VinhThoHo/ph_air_shower_hw/ph_air_shower_relay_hw/README.md

# ph_pcr_cabinet_relay_hw
This is relay hardware for project PCR Cabinets.

# Description

## Features:
    * Điện áp ngõ vào 12VDC.
    * Hỗ trợ 3 ngõ ra kích hoạt thông qua các relay.
    * Hỗ trợ 5 cổng output mở rộng kết nối với các thiết bị ngoại vi.
# Hardware
## Schematics

[Download](./ph_pcr_cabinet_relay_hw.pdf)

## PCB Layout

PCB-IMG

## 3D

TOP-3D-IMG

BOT-3D-IMG

## Pinout

# Gerber

[Download](./gerber/gerber_ph_pcr_cabinet_relay_hw.zip)

# BOMLIST

[Download](./assets/ph_pcr_cabinet_relay_hw.csv)

# FRAME PCB

[Download](./assets/ph_pcr_cabinet_frame_relay.dxf)

# License

PHUONGHAI
