VinhThoHo/ph_air_shower_hw/ph_air_shower_relay_hw/assets/ph_air_shower_relay_3d_bot_hw.png

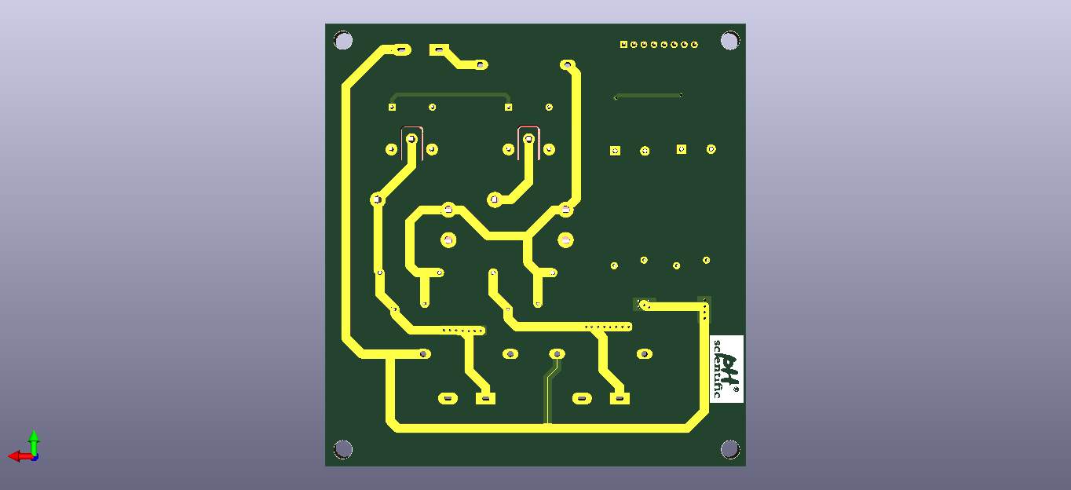
ph_air_shower_relay_hw/assets/ph_air_shower_relay_3d_bot_hw.png
