VinhThoHo/ph_air_shower_hw/ph_air_shower_relay_hw/assets/ph_frame_air_shower_relay_hw.dxf

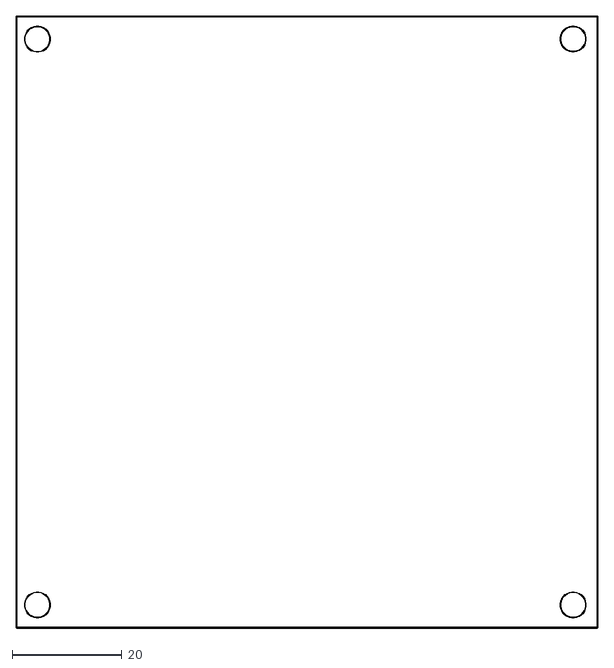
[picture p5: CAD file, 2020-05-18]
ph_air_shower_relay_hw/assets/ph_frame_air_shower_relay_hw.dxf
105.8 x 111.4
