VinhThoHo/ph_air_shower_hw/Documents/Diagram_Block_Air_Shower.pdf

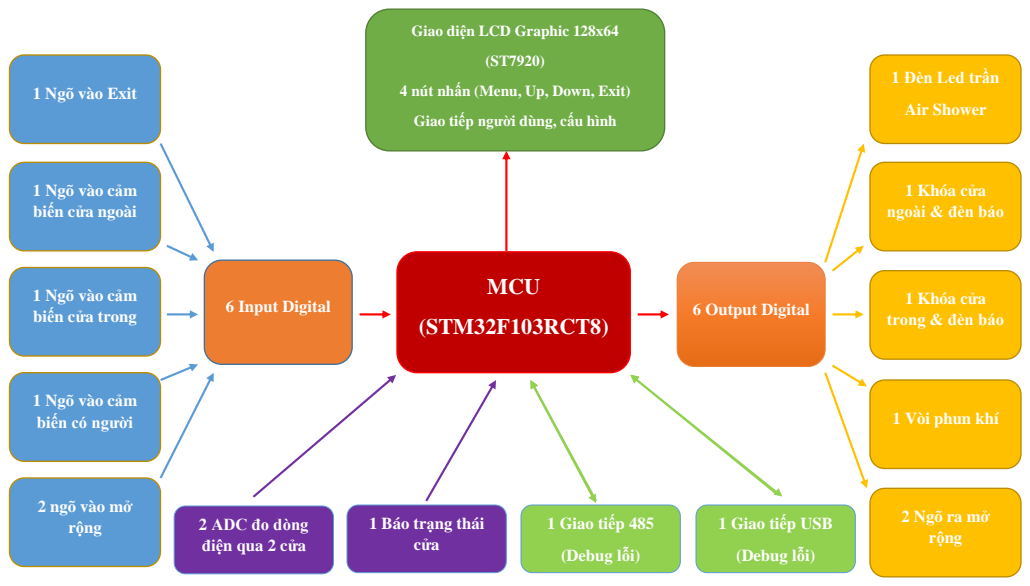
[picture p6: page 1]
MCU; (STM32F103RCT8); 6 Input Digital; 1 Giao tiếp 485; (Debug lỗi); 6 Output Digital; Air Shower; cửa

Giao diện LCD Graphic 128x64

1 Đèn Led trần

4 nút nhấn (Menu, Up, Down, Exit)

1 Ngõ vào Exit

Giao tiếp người dùng, cấu hình

1 Ngõ vào cảm
biến cửa ngoài

1 Khóa cửa
ngoài & đèn báo

biến cửa trong

trong & đèn báo

biến có người

1 Vòi phun khí

2 ngõ vào mở
rộng

1 Giao tiếp USB

2 Ngõ ra mở

2 ADC đo dòng
điện qua 2 cửa

1 Báo trạng thái
