VinhThoHo/ph_air_shower_hw/Documents/diagram_system_connect_ph_air_shower_hw.pdf

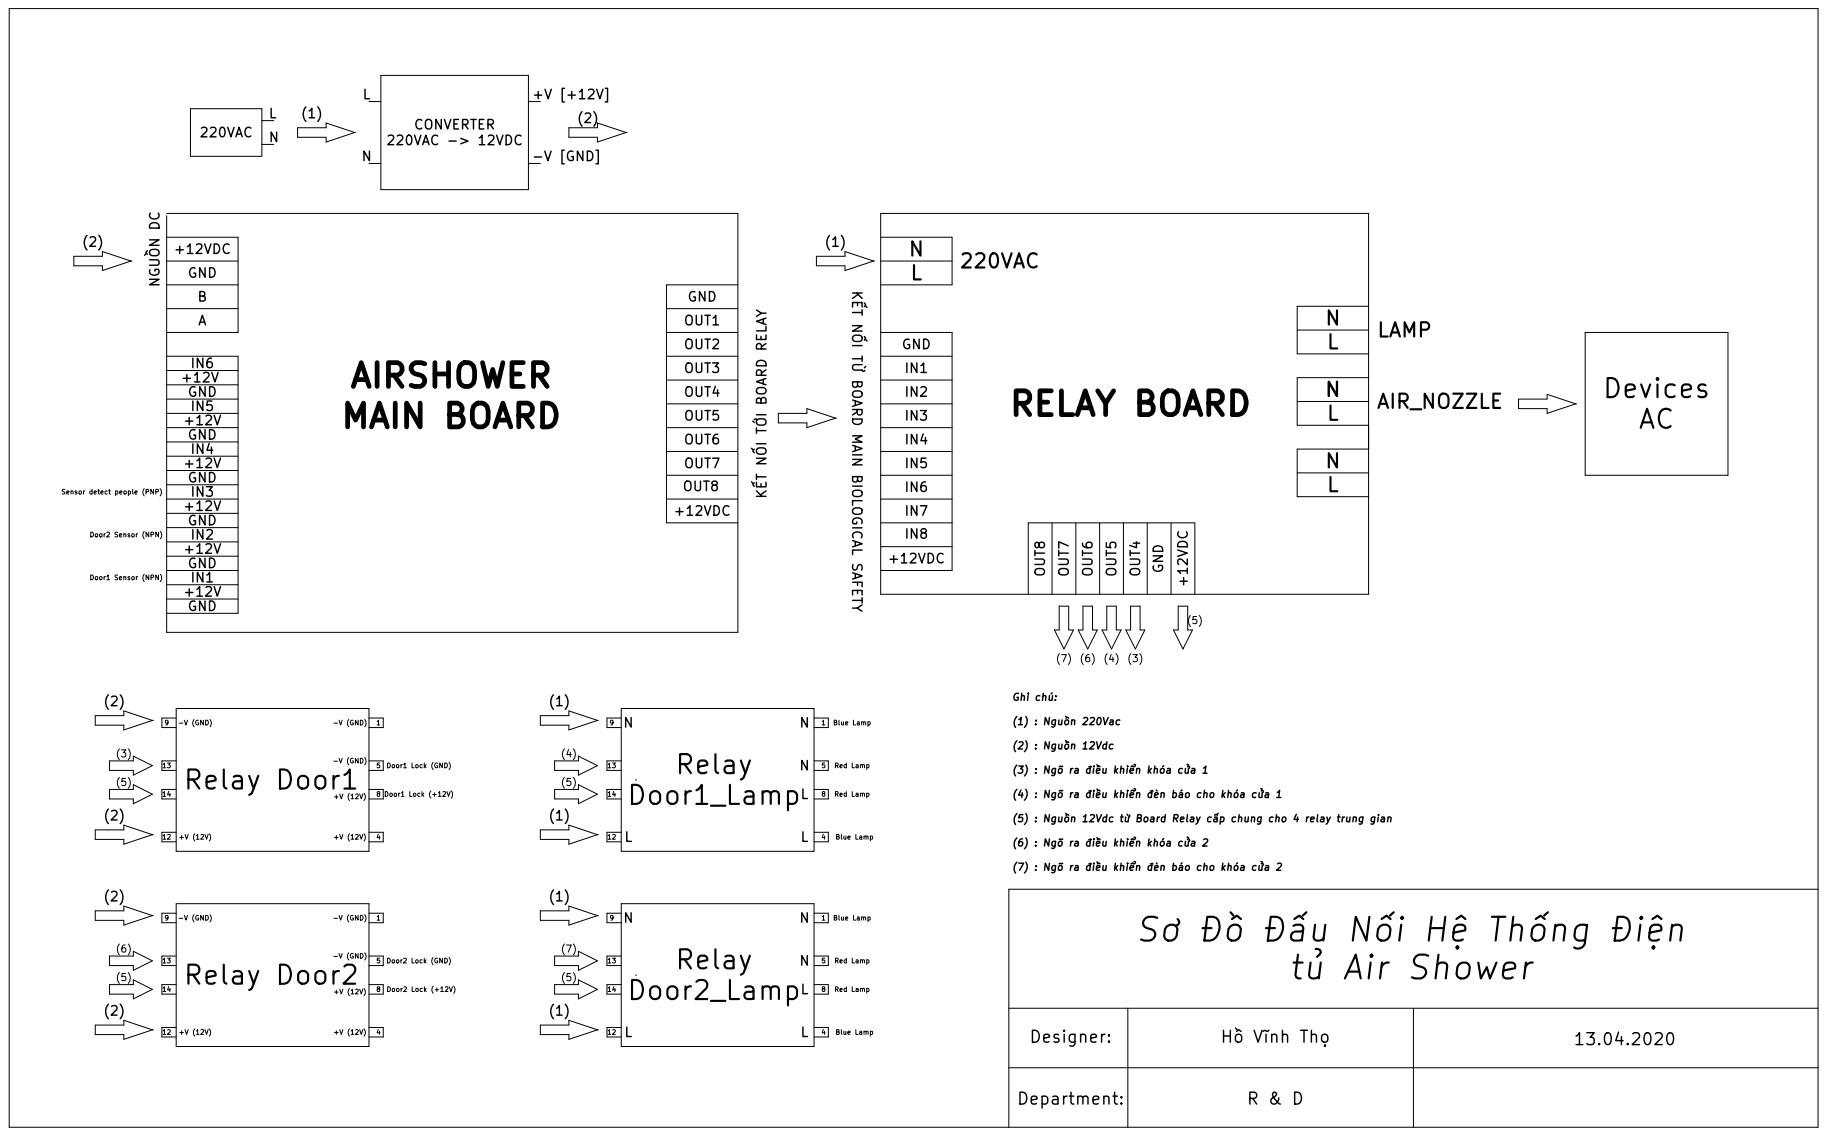
[picture p7: page 1]

IN5
+12V
IN4
IN3
IN2
IN1

Red Lamp

(3) : Ngõ ra iu khin khóa ca 1

(4) : Ngõ ra iu khin èn báo cho khóa ca 1

(5) : Ngun 12Vdc t Board Relay cp chung cho 4 relay trung gian

(6) : Ngõ ra iu khin khóa ca 2

(7) : Ngõ ra iu khin èn báo cho khóa ca 2

Designer: | | 13.04.2020

Department: | R & D
