VinhThoHo/ph_air_shower_hw/ph_air_shower_controller_hw/documents/diagram_system_connect_ph_air_shower_hw.pdf

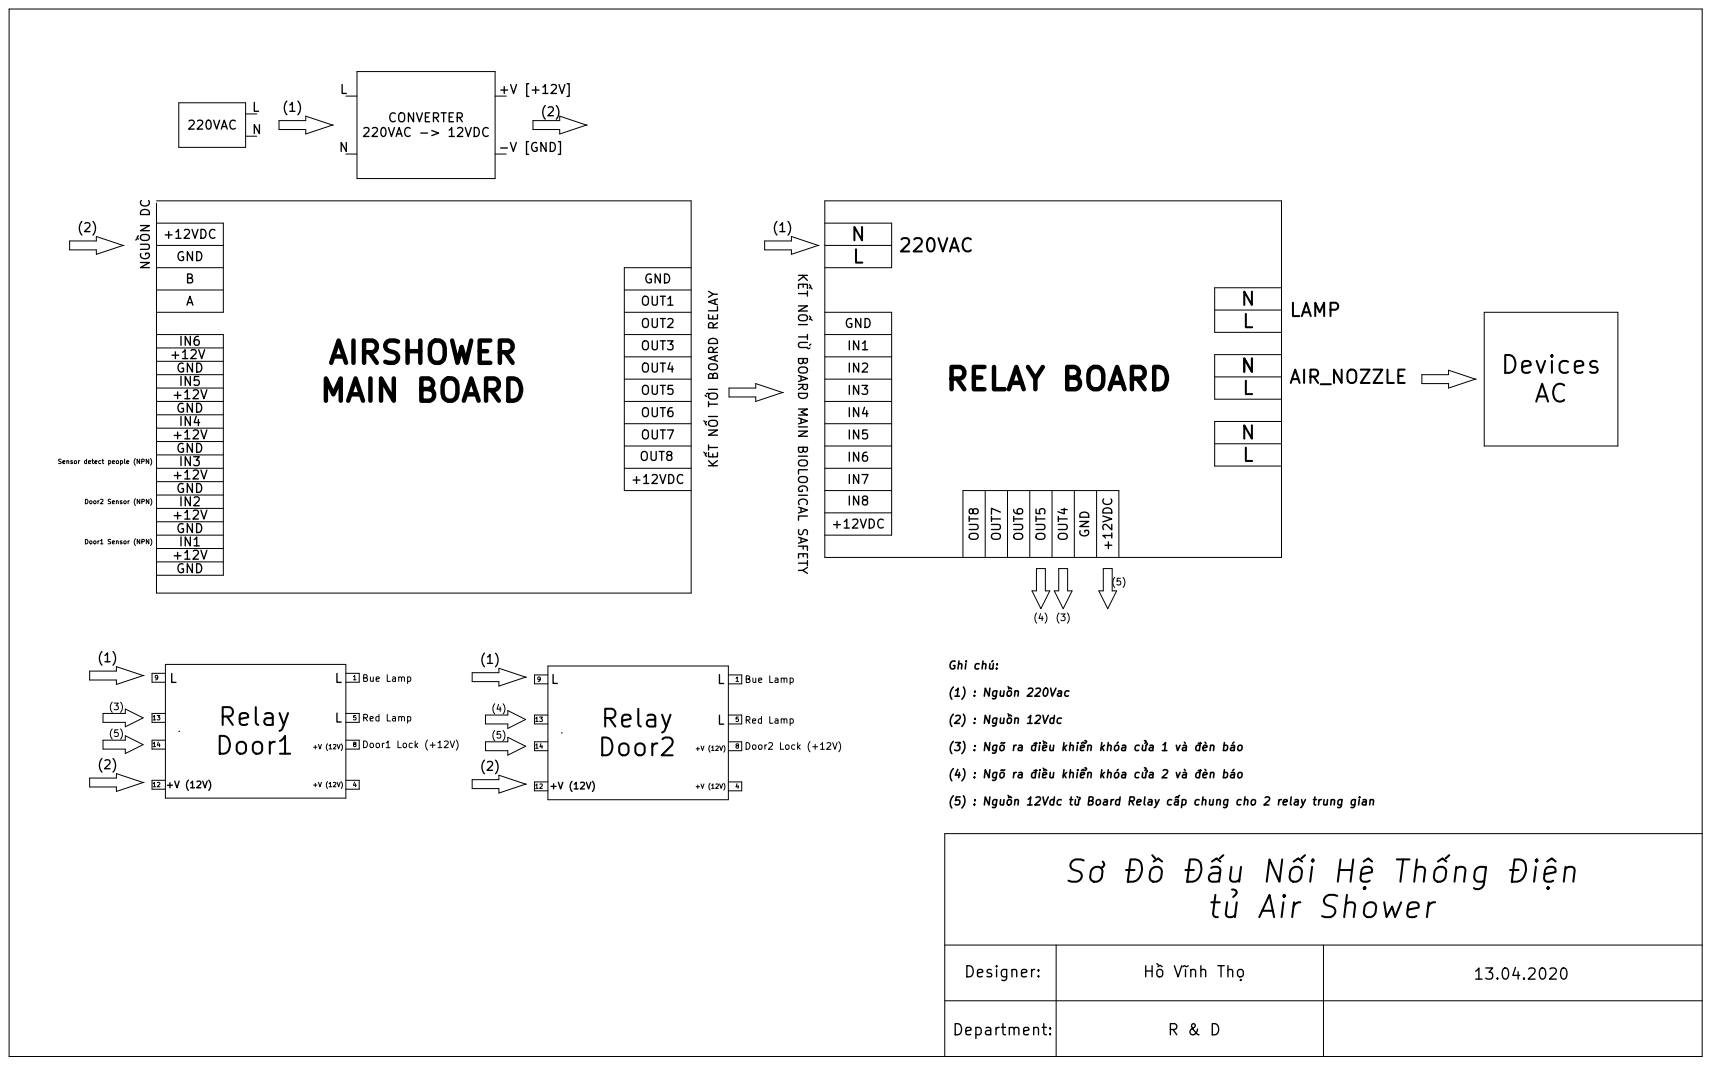
[picture p8: page 1]

IN5
+12V
IN4
IN3
IN2
IN1

(3) : Ngõ ra iu khin khóa ca 1 và èn báo

(4) : Ngõ ra iu khin khóa ca 2 và èn báo

(5) : Ngun 12Vdc t Board Relay cp chung cho 2 relay trung gian

Designer: | | 13.04.2020

Department: | R & D
