VinhThoHo/ph_air_shower_hw/ph_air_shower_relay_hw/ph_air_shower_relay(2C)_hw.pdf

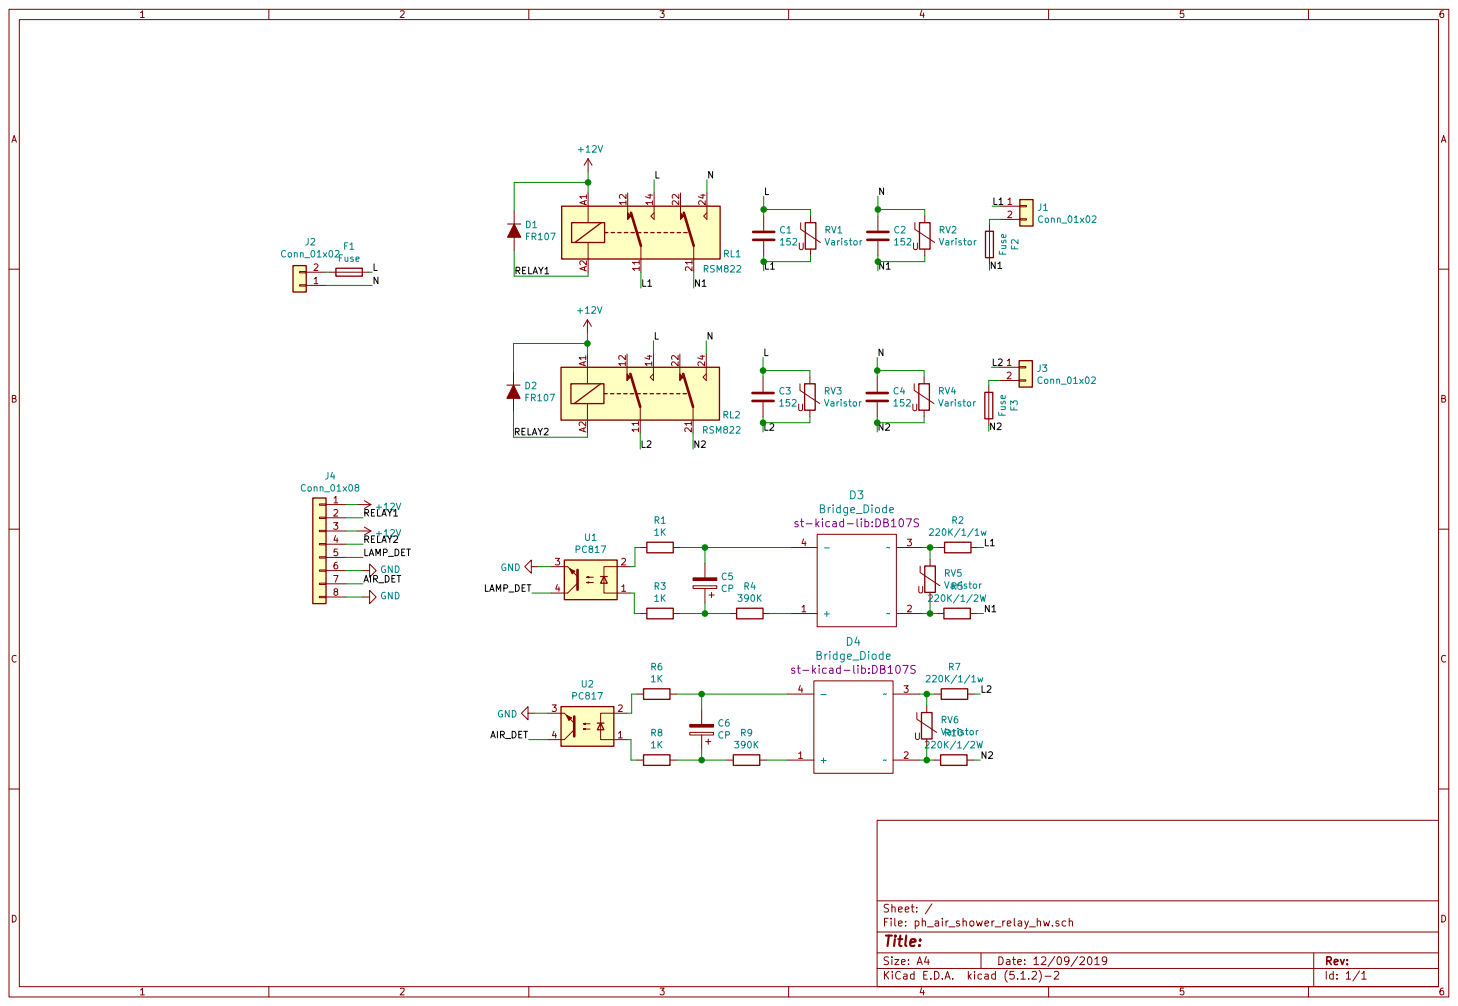
[picture p9: page 1]
