VinhThoHo/ph_air_shower_hw/ph_air_shower_controller_hw/documents/ph_air_shower_controller_hw.pdf

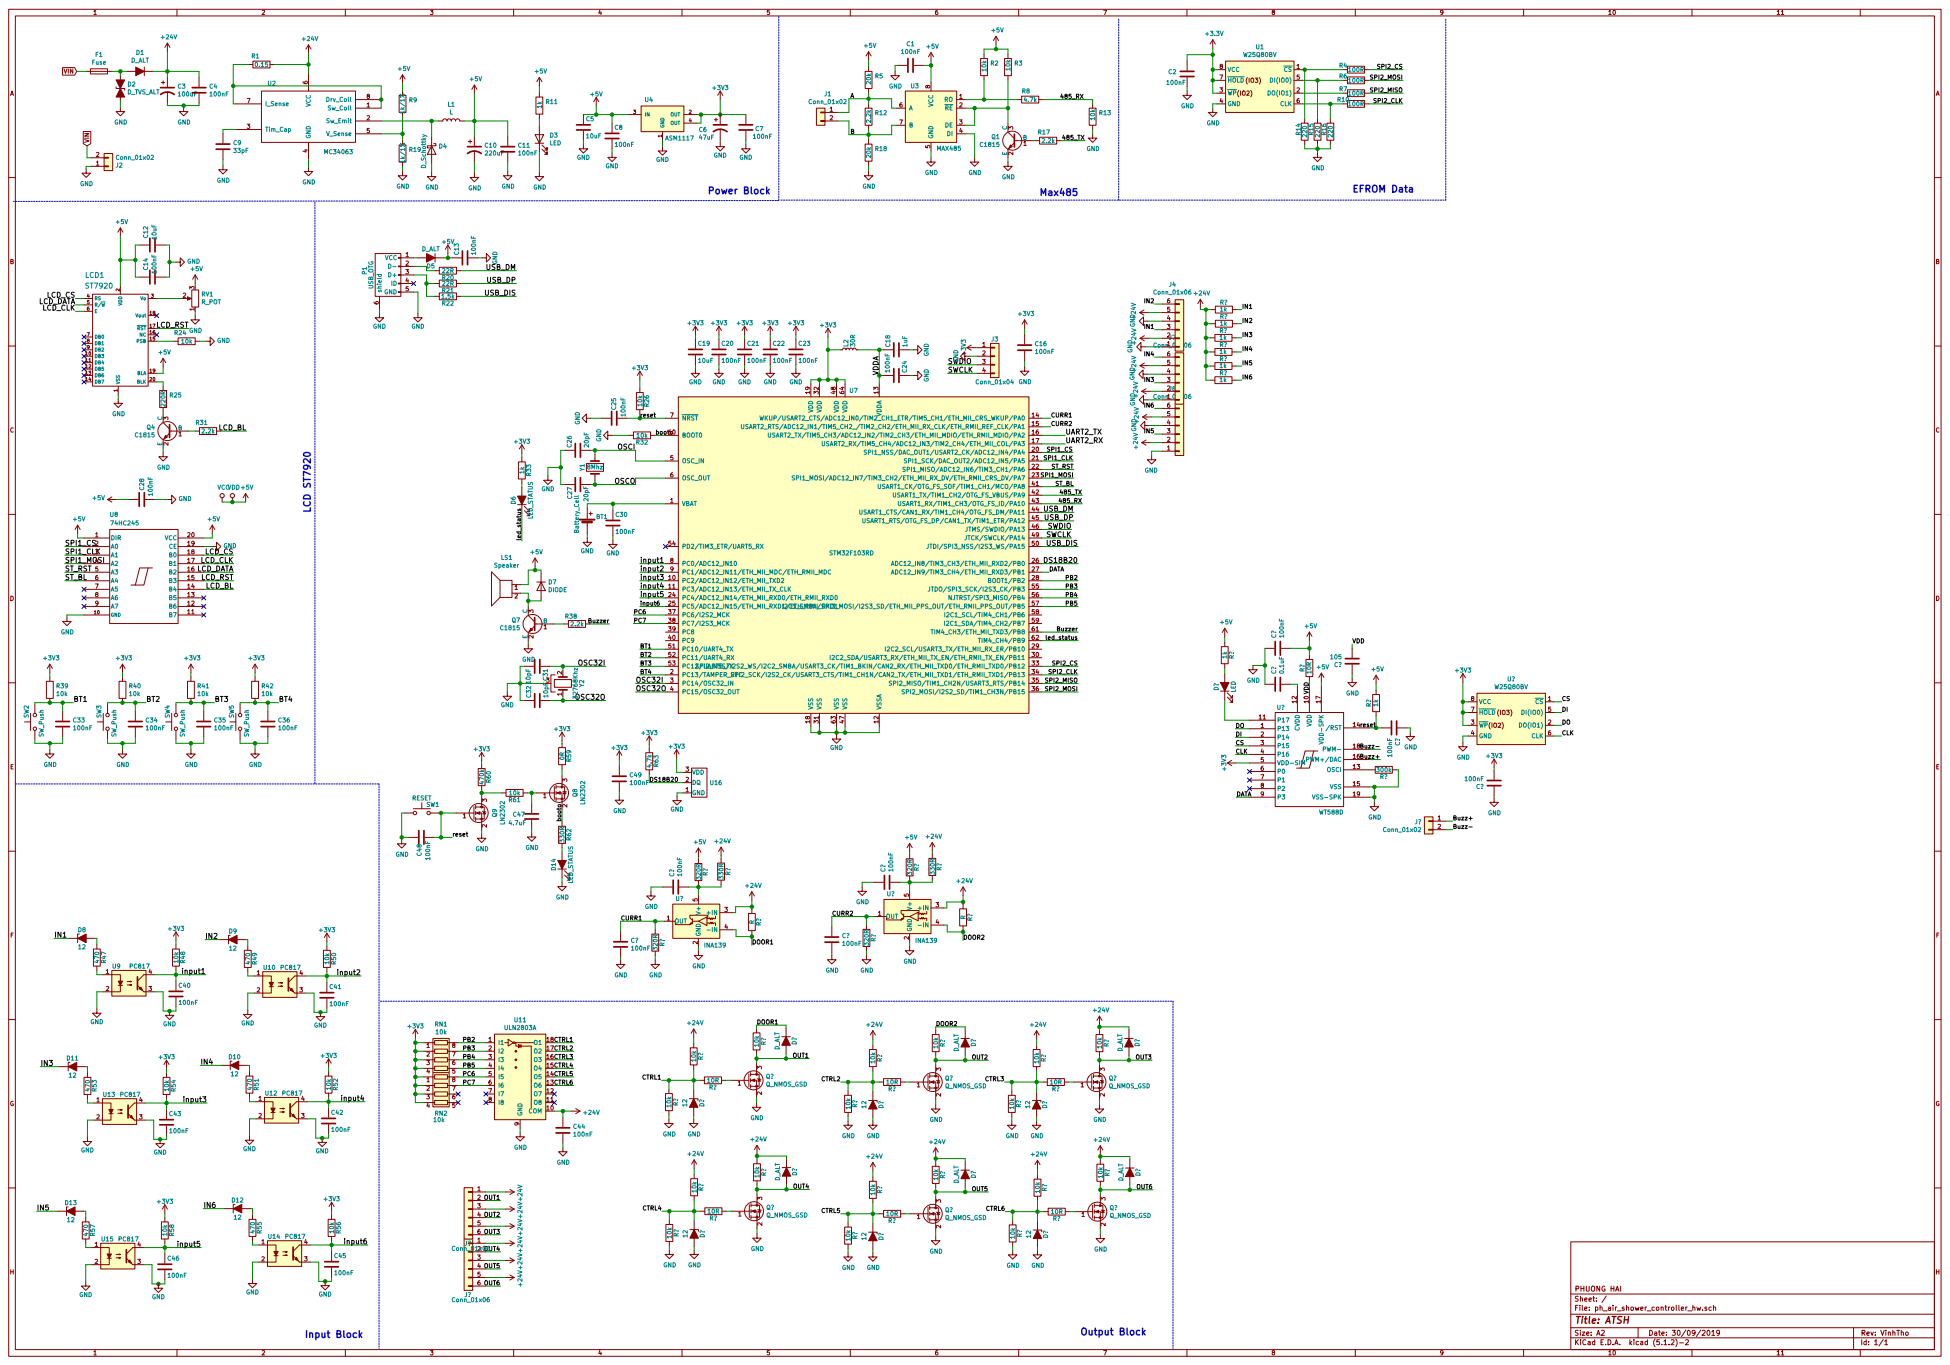
[picture p10: page 1]

1 DB3 10 DB4 11 DB5 12 DB6 13 DB7 14 PSB 15 NC 16 RST 17 Vout 18 BLA 19 VDD

JTMS/SWDIO/PA13 46 VSS 47 VDD 48

LCD_CLK
LCD_DATA
LCD_RST

1 | 10k 1 | | I2 2
2 | | PB2 PB3 PB4 PB5 PC6 PC7 7 | I3 3

3 | | 6 | I4 4
4 | | 5 | I5 5
2 | 8 RN2 7 | I7 7

File: ph_air_shower_controller_hw.sch Sheet: / PHUONG HAI
