VinhThoHo/ph_air_shower_hw/ph_air_shower_controller_hw/ph_air_shower_controller_hw.kicad_pcb

## KiCad design ph_air_shower_controller_hw/ph_air_shower_controller_hw.kicad_pcb (2020-03-13)

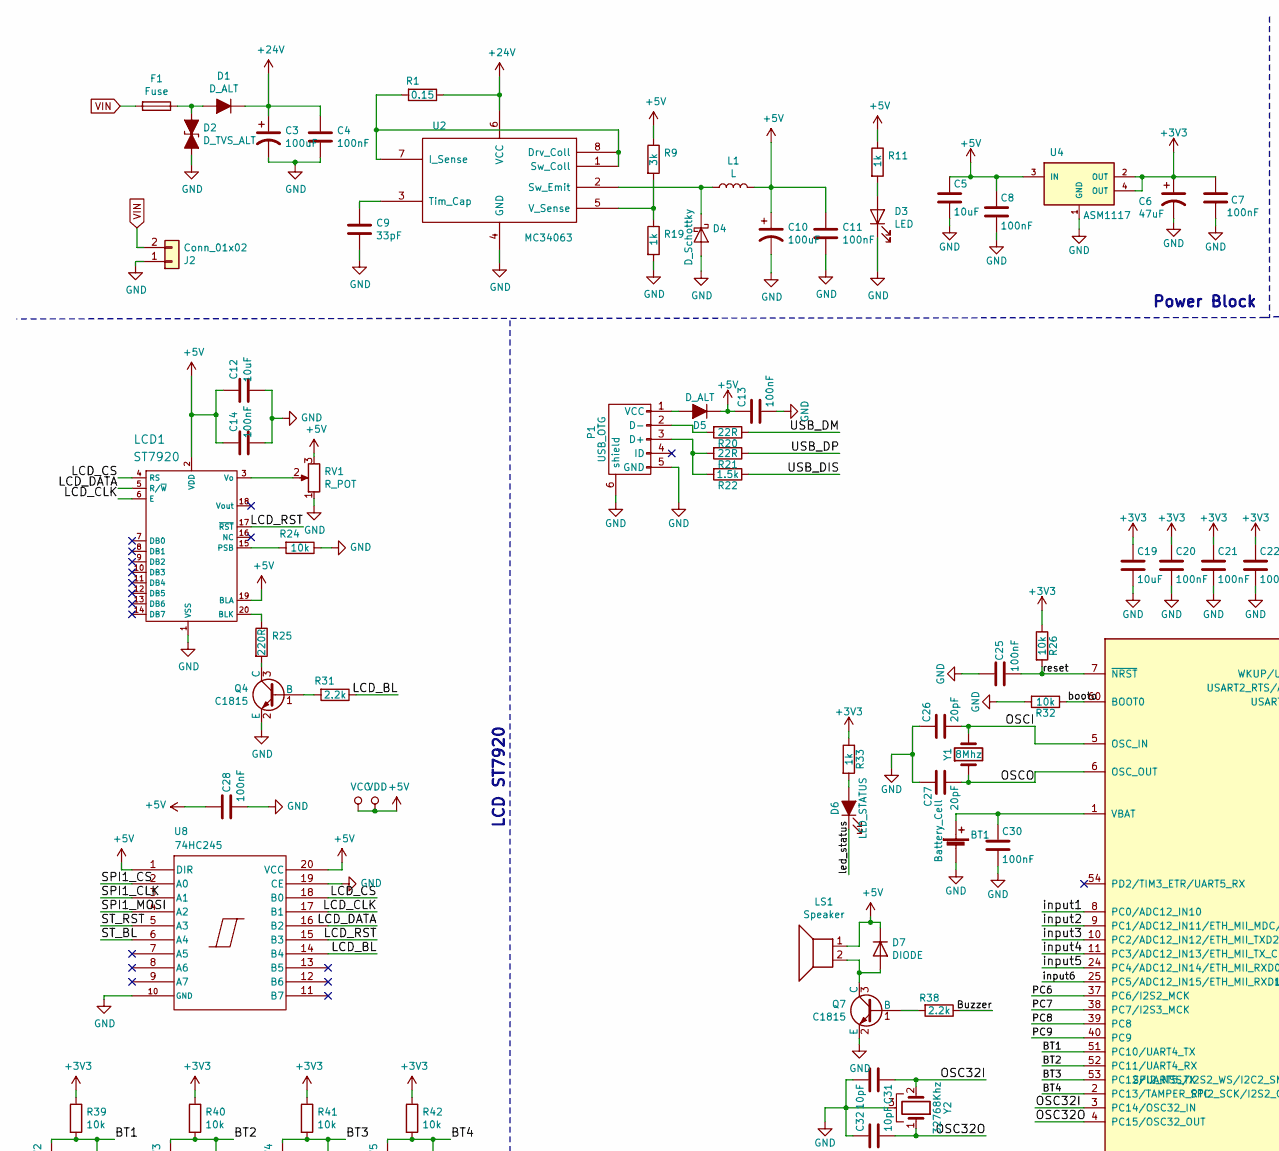
[picture p11: schematic ph_air_shower_controller_hw.sch, ATSH, part in row 1, column 1]

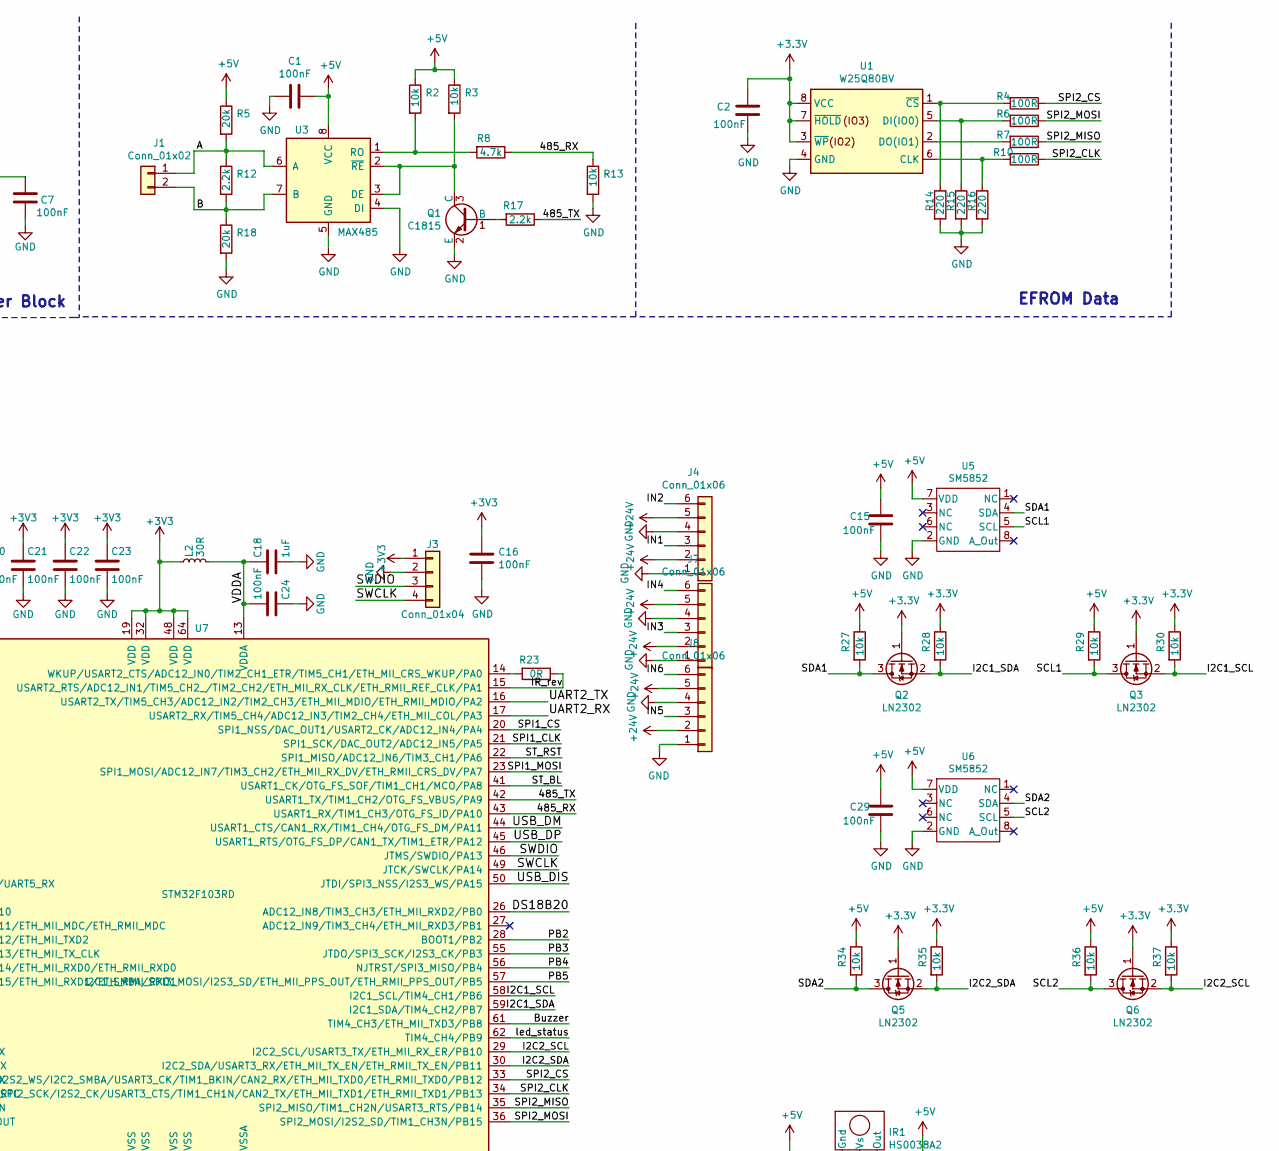
[picture p12: schematic ph_air_shower_controller_hw.sch, ATSH, part in row 1, column 2]

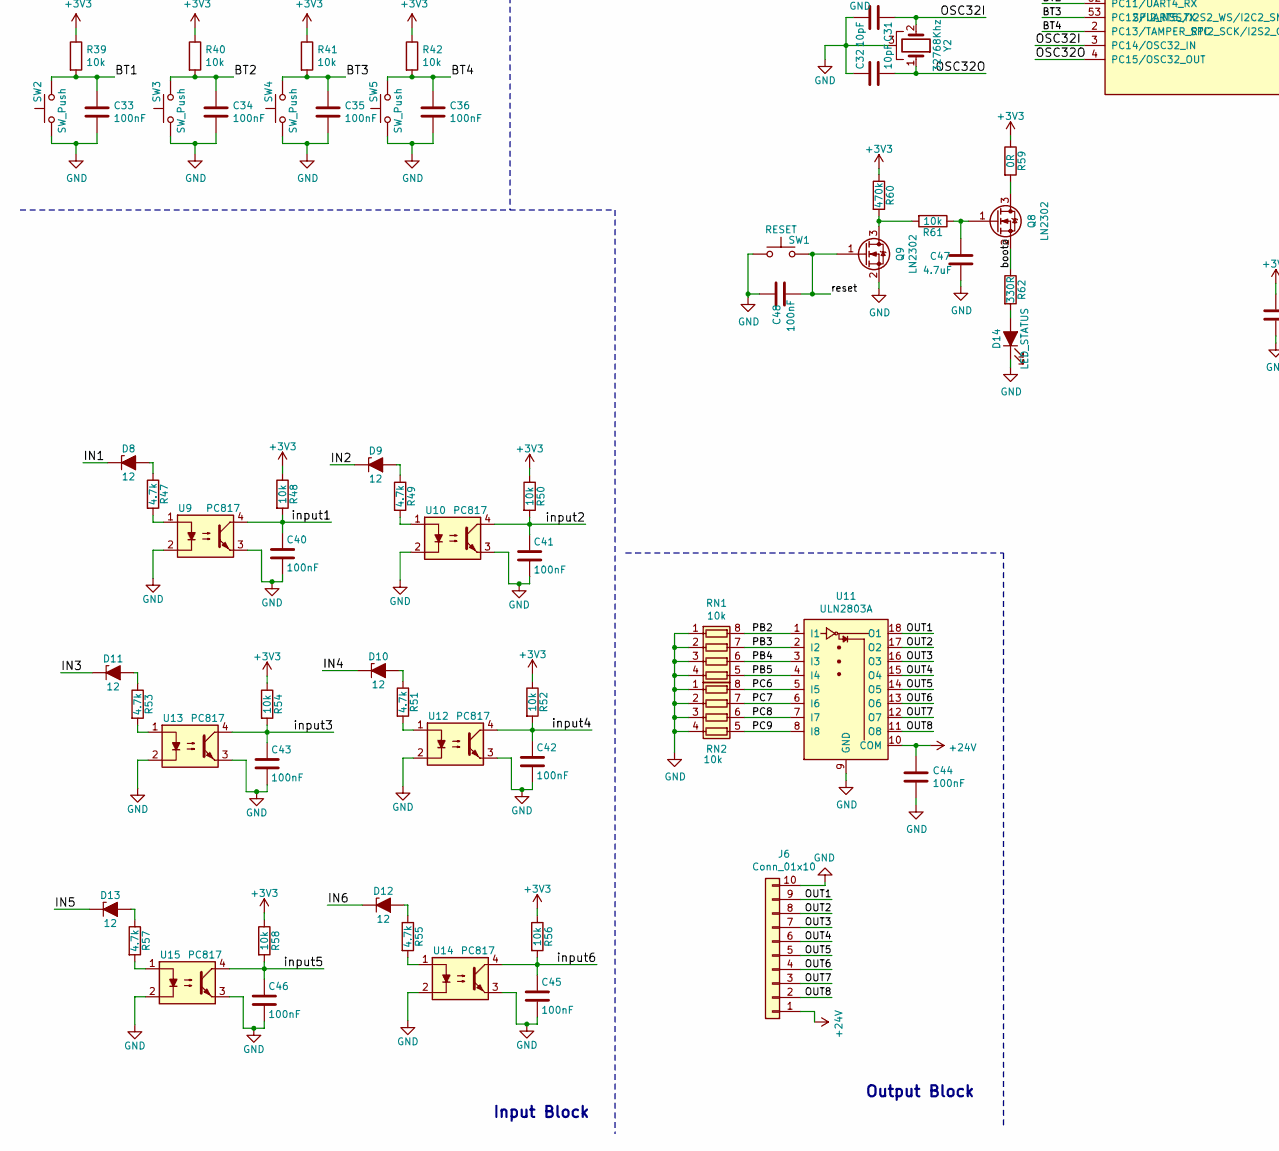
[picture p13: schematic ph_air_shower_controller_hw.sch, ATSH, part in row 2, column 1]

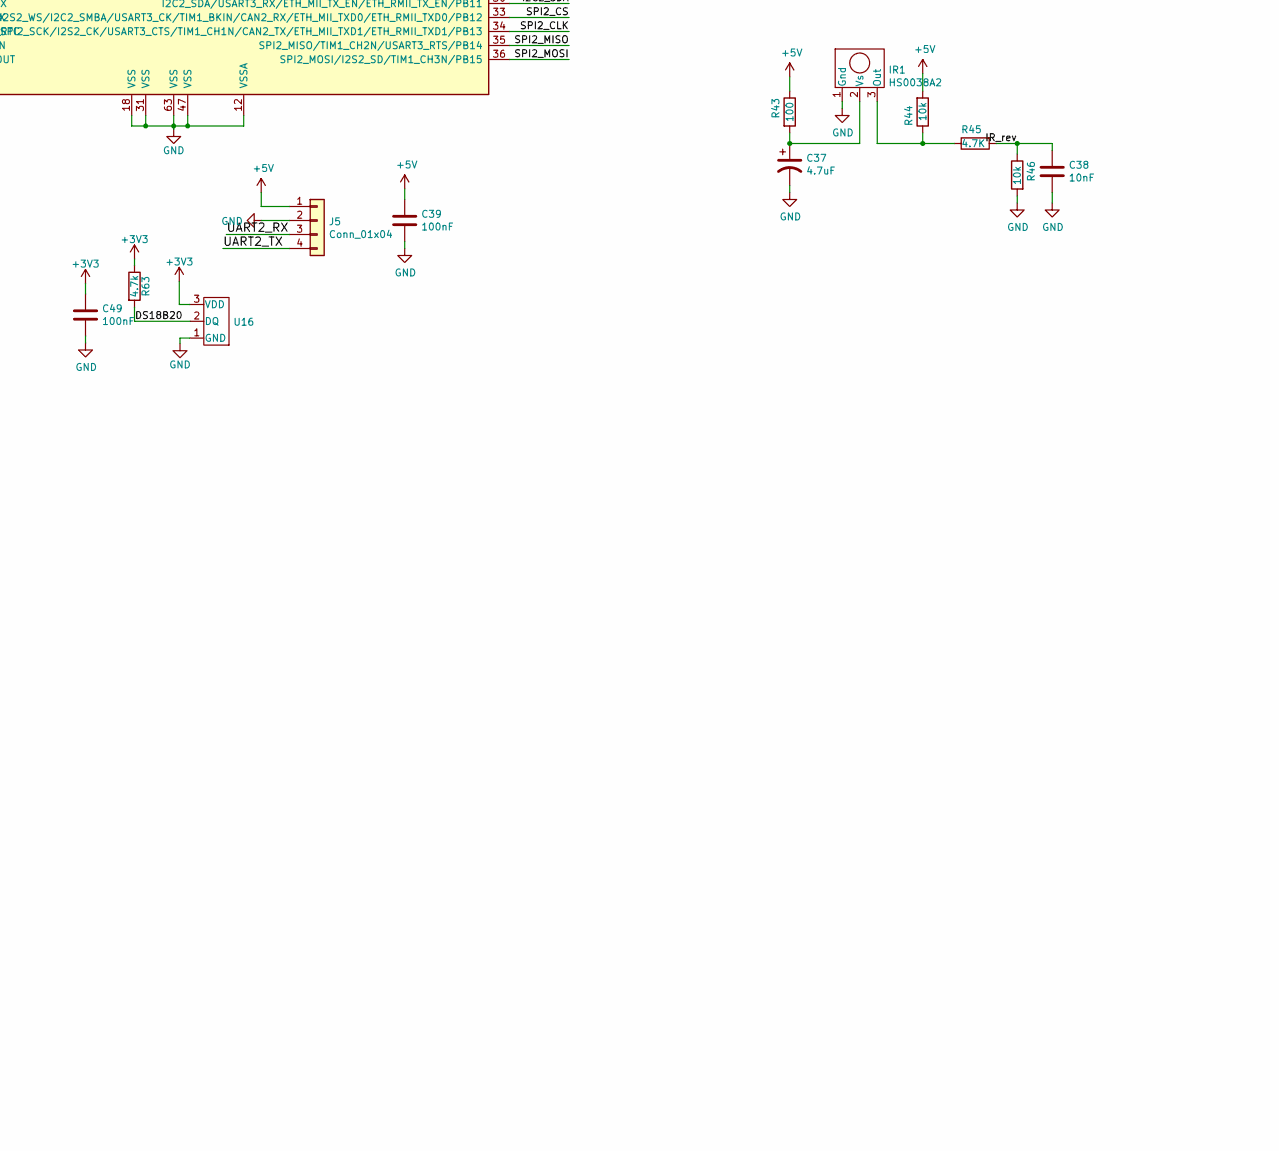
[picture p14: schematic ph_air_shower_controller_hw.sch, ATSH, part in row 2, column 2]

Parts:
BT1: Battery_Cell; BT3V3
C1, C2, C4, C7, C8, C11, C13, C14, C15, C16, C20, C21, C22, C23, C24, C25, C28, C29, C30, C33, C34, C35, C36, C39, C40, C41, C42, C43, C44, C45, C46, C48, C49: 100nF; C_0805_2012Metric_Pad1.15x1.40mm_HandSolder
C3, C10: 100uF; CP_Elec_8x10.5
C5, C12, C19: 10uF; C_1206_3216Metric_Pad1.42x1.75mm_HandSolder
C6: 47uF; CP_Elec_5x5.4
C9: 33pF; C_0805_2012Metric_Pad1.15x1.40mm_HandSolder
C18: 1uF; C_0805_2012Metric_Pad1.15x1.40mm_HandSolder
C26, C27: 20pF; C_0805_2012Metric_Pad1.15x1.40mm_HandSolder
C31, C32: 10pF; C_0805_2012Metric_Pad1.15x1.40mm_HandSolder
C37: 4.7uF; CP_EIA-3216-18_Kemet-A_Pad1.58x1.35mm_HandSolder
C38: 10nF; C_0805_2012Metric_Pad1.15x1.40mm_HandSolder
C47: 4.7uF; C_1206_3216Metric_Pad1.42x1.75mm_HandSolder
D1: D_ALT; D_SMB_Handsoldering
D2: D_TVS_ALT; D_SMA_Standard
D3: LED; LED_0805_2012Metric_Pad1.15x1.40mm_HandSolder
D4: D_Schottky; D_SMA_Handsoldering
D5: D_ALT; D_SOD-123
D6, D14: LED_STATUS; LED_0805_2012Metric_Pad1.15x1.40mm_HandSolder
D7: DIODE; D_SOD-123
D8, D9, D10, D11, D12, D13: 12; SOD-80
F1: Fuse; Fuse_SMD1812
IR1: HS0038A2
J1, J2: Conn_01x02; TerminalBlock_WAGO-236_2Stift_R5mm_2pol
J3, J5: Conn_01x04; Pin_Header_Straight_1x04_Pitch2.54mm
J4, J7, J8: Conn_01x06; TerminalBlock_WAGO_2.54mm_6P
J6: Conn_01x10; PinSocket_1x10_P2.54mm_Vertical
L1: L; Inductor_5.2x5.8x4.5
L2: 30R; L_0805_2012Metric_Pad1.15x1.40mm_HandSolder
LCD1: ST7920
LS1: Speaker; Buzzer_15x7.5RM7.6
P1: USB_OTG; USB_Micro-B
Q1, Q4, Q7: C1815; SOT-23
Q2, Q3, Q5, Q6, Q8, Q9: LN2302; SOT-23
R1: 0.15; R_1206_3216Metric_Pad1.42x1.75mm_HandSolder
R2, R3, R13, R24, R26, R27, R28, R29, R30, R32, R34, R35, R36, R37, R39, R40, R41, R42, R44, R46, R48, R50, R52, R54, R56, R58, R61: 10k; R_0805_2012Metric_Pad1.15x1.40mm_HandSolder
R4, R6, R7, R10: 100R; R_0805_2012Metric_Pad1.15x1.40mm_HandSolder
R5, R18: 20k; R_0805_2012Metric_Pad1.15x1.40mm_HandSolder
R8, R47, R49, R51, R53, R55, R57, R63: 4.7k; R_0805_2012Metric_Pad1.15x1.40mm_HandSolder
R9: 3k; R_0805_2012Metric_Pad1.15x1.40mm_HandSolder
R11, R19, R33: 1k; R_0805_2012Metric_Pad1.15x1.40mm_HandSolder
R12, R17, R31, R38: 2.2k; R_0805_2012Metric_Pad1.15x1.40mm_HandSolder
R14, R15, R16: 220; R_0805_2012Metric_Pad1.15x1.40mm_HandSolder
R20, R21: 22R; R_0805_2012Metric_Pad1.15x1.40mm_HandSolder
R22: 1.5k; R_0805_2012Metric_Pad1.15x1.40mm_HandSolder
R23, R59: 0R; R_0805_2012Metric_Pad1.15x1.40mm_HandSolder
R25: 220R; R_0805_2012Metric_Pad1.15x1.40mm_HandSolder
R43: 100; R_0805_2012Metric_Pad1.15x1.40mm_HandSolder
R45: 4.7K; R_0805_2012Metric_Pad1.15x1.40mm_HandSolder
R60: 470k; R_0805_2012Metric_Pad1.15x1.40mm_HandSolder
R62: 330R; R_0805_2012Metric_Pad1.15x1.40mm_HandSolder
RN1, RN2: 10k; R_Array_Convex_4x0603
RV1: R_POT; VR1
SW1: RESET; Button_SW_2PIN
SW2, SW3, SW4, SW5: SW_Push; SW_PUSH-12mm
U1: W25Q80BV; SOIC-8_3.9x4.9mm_Pitch1.27mm
U2: MC34063; SOIC-8_3.9x4.9mm_Pitch1.27mm
U3: MAX485; SOIC-8_3.9x4.9mm_Pitch1.27mm
U4: ASM1117; SOT-223
U5, U6: SM5852
U7: STM32F103RD; LQFP-64_10x10mm_Pitch0.5mm
U8: 74HC245; TSSOP-20_4.4x6.5mm_Pitch0.65mm
U9, U10, U12, U13, U14, U15: PC817; Optocoupler_SMD
U11: ULN2803A; SOIC-18W_7.5x11.6mm_Pitch1.27mm
U16: DS18B20; TO-92_Inline_Horizontal2
Y1: 8Mhz; Crystal_SMD_HC49-SD
Y2: 32768Khz; Crystal_Round_Horizontal_3mm_smd

Connections:
+5V: C1.1, C5.1, C8.1, C10.1, C11.1, C12.2, C13.1, C14.2, C15.1, C28.1, C29.1, C39.1, D5.1 (K), D7.2 (K), J5.1, L1.2, LCD1.2 (VDD), LCD1.19 (BLA), LS1.1, R2.1, R3.1, R5.1, R9.1, R11.1, R27.1, R29.1, R34.1, R36.1, R43.1, R44.2, RV1.3, U3.8 (VCC), U4.3 (IN), U5.7 (VDD), U6.7 (VDD), U8.1 (DIR), U8.20 (VCC); also elsewhere on the board
+24V: C3.1, C4.1, C44.1, D1.1 (K), J4.2, J4.5, J6.1, J7.2, J7.5, J8.2, J8.5, R1.1, U2.6 (VCC), U11.10 (COM)
/485_RX: R8.1, R13.1, U7.43 (USART1_RX/TIM1_CH3/OTG_FS_ID/PA10)
/485_TX: R17.1, U7.42 (USART1_TX/TIM1_CH2/OTG_FS_VBUS/PA9)
/A: J1.1, R5.2, R12.1, U3.6 (A)
/B: J1.2, R12.2, R18.1, U3.7 (B)
/BT1: C33.1, R39.2, SW2.2, U7.51 (PC10/UART4_TX)
/BT2: C34.1, R40.2, SW3.2, U7.52 (PC11/UART4_RX)
/BT3: C35.1, R41.2, SW4.2, U7.53 (PC12/UART5_TX)
/BT4: C36.1, R42.2, SW5.2, U7.2 (PC13/TAMPER_RTC)
/Buzzer: R38.1, U7.61 (TIM4_CH3/ETH_MII_TXD3/PB8)
/DS18B20: R63.2, U7.26 (ADC12_IN8/TIM3_CH3/ETH_MII_RXD2/PB0), U16.2 (DQ)
/I2C1_SCL: Q3.2 (S), R30.2, U7.58 (I2C1_SCL/TIM4_CH1/PB6)
/I2C1_SDA: Q2.2 (S), R28.2, U7.59 (I2C1_SDA/TIM4_CH2/PB7)
/I2C2_SCL: Q6.2 (S), R37.2, U7.29 (I2C2_SCL/USART3_TX/ETH_MII_RX_ER/PB10)
/I2C2_SDA: Q5.2 (S), R35.2, U7.30 (I2C2_SDA/USART3_RX/ETH_MII_TX_EN/ETH_RM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)
/IN1: D8.1 (K), J4.3
/IN2: D9.1 (K), J4.6
/IN3: D11.1 (K), J7.3
/IN4: D10.1 (K), J7.6
/IN5: D13.1 (K), J8.3
/IN6: D12.1 (K), J8.6
/IR_rev: C38.1, R23.1, R45.2, R46.1, U7.15 (USART2_RTS/ADC12_IN1/TIM5_CH2_/TIM2_CH2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)
/LCD_BL: R31.1, U8.14 (B4)
/LCD_CLK: LCD1.6 (E), U8.17 (B1)
/LCD_CS: LCD1.4 (RS), U8.18 (B0)
/LCD_DATA: LCD1.5 (R/~W), U8.16 (B2)
/LCD_RST: LCD1.17 (~RST), U8.15 (B3)
/OSC32I: C31.1, U7.3 (PC14/OSC32_IN), Y2.2
/OSC32O: C32.2, U7.4 (PC15/OSC32_OUT), Y2.1
/OSCI: C26.2, U7.5 (OSC_IN), Y1.2
/OSCO: C27.1, U7.6 (OSC_OUT), Y1.1
/OUT1: J6.9, U11.18 (O1)
/OUT2: J6.8, U11.17 (O2)
/OUT3: J6.7, U11.16 (O3)
/OUT4: J6.6, U11.15 (O4)
/OUT5: J6.5, U11.14 (O5)
/OUT6: J6.4, U11.13 (O6)
/OUT7: J6.3, U11.12 (O7)
/OUT8: J6.2, U11.11 (O8)
/PB2: RN1.8 (R1.2), U7.28 (BOOT1/PB2), U11.1 (I1)
/PB3: RN1.7 (R2.2), U7.55 (JTDO/SPI3_SCK/I2S3_CK/PB3), U11.2 (I2)
/PB4: RN1.6 (R3.2), U7.56 (NJTRST/SPI3_MISO/PB4), U11.3 (I3)
/PB5: RN1.5 (R4.2), U7.57 (I2C1_SMBA/SPI3_MOSI/I2S3_SD/ETH_MII_PPS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), U11.4 (I4)
/PC6: RN2.8 (R1.2), U7.37 (PC6/I2S2_MCK), U11.5 (I5)
/PC7: RN2.7 (R2.2), U7.38 (PC7/I2S3_MCK), U11.6 (I6)
/PC8: RN2.6 (R3.2), U7.39 (PC8), U11.7 (I7)
/PC9: RN2.5 (R4.2), U7.40 (PC9), U11.8 (I8)
/SCL1: Q3.3 (D), R29.2, U5.5 (SCL)
/SCL2: Q6.3 (D), R36.2, U6.5 (SCL)
/SDA1: Q2.3 (D), R27.2, U5.4 (SDA)
/SDA2: Q5.3 (D), R34.2, U6.4 (SDA)
/SPI1_CLK: U7.21 (SPI1_SCK/DAC_OUT2/ADC12_IN5/PA5), U8.3 (A1)
/SPI1_CS: U7.20 (SPI1_NSS/DAC_OUT1/USART2_CK/ADC12_IN4/P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), U8.2 (A0)
/SPI1_MOSI: U7.23 (SPI1_MOSI/ADC12_IN7/TIM3_CH2/ETH_MII_RX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), U8.4 (A2)
/SPI2_CLK: R10.1, U7.34 (SPI2_SCK/I2S2_CK/USART3_CTS/TIM1_CH1N/C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)
/SPI2_CS: R4.1, U7.33 (SPI2_NSS/I2S2_WS/I2C2_SMBA/USART3_CK/TI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)
/SPI2_MISO: R7.1, U7.35 (SPI2_MISO/TIM1_CH2N/USART3_RTS/PB14)
/SPI2_MOSI: R6.1, U7.36 (SPI2_MOSI/I2S2_SD/TIM1_CH3N/PB15)
/ST_BL: U7.41 (USART1_CK/OTG_FS_SOF/TIM1_CH1/MCO/PA8), U8.6 (A4)
/ST_RST: U7.22 (SPI1_MISO/ADC12_IN6/TIM3_CH1/PA6), U8.5 (A3)
/SWCLK: J3.4, U7.49 (JTCK/SWCLK/PA14)
/SWDIO: J3.3, U7.46 (JTMS/SWDIO/PA13)
/UART2_RX: J5.3, U7.17 (USART2_RX/TIM5_CH4/ADC12_IN3/TIM2_CH4/E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)
/UART2_TX: J5.4, U7.16 (USART2_TX/TIM5_CH3/ADC12_IN2/TIM2_CH3/E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)
/USB_DIS: R22.1, U7.50 (JTDI/SPI3_NSS/I2S3_WS/PA15)
/USB_DM: R20.1, U7.44 (USART1_CTS/CAN1_RX/TIM1_CH4/OTG_FS_DM/P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)
/USB_DP: R21.1, U7.45 (USART1_RTS/OTG_FS_DP/CAN1_TX/TIM1_ETR/P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)
/VDDA: C18.1, C24.2, L2.2, U7.13 (VDDA)
/booto: Q8.2 (S), R32.1, R62.1, U7.60 (BOOT0)
/input1: C40.1, R48.2, U7.8 (PC0/ADC12_IN10), U9.4
/input2: C41.1, R50.2, U7.9 (PC1/ADC12_IN11/ETH_MII_MDC/ETH_RMII_MDC), U10.4
/input3: C43.1, R54.2, U7.10 (PC2/ADC12_IN12/ETH_MII_TXD2), U13.4
/input4: C42.1, R52.2, U7.11 (PC3/ADC12_IN13/ETH_MII_TX_CLK), U12.4
/input5: C46.1, R58.2, U7.24 (PC4/ADC12_IN14/ETH_MII_RXD0/ETH_RMII_RX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), U15.4
/input6: C45.1, R56.2, U7.25 (PC5/ADC12_IN15/ETH_MII_RXD1/ETH_RMII_RX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), U14.4
/led_status: D6.1 (K), U7.62 (TIM4_CH4/PB9)
/reset: C25.2, C48.2, Q9.1 (G), R26.2, SW1.2, U7.7 (~NRST)
GND: BT1.2 (-), C1.2, C2.2, C3.2, C4.2, C5.2, C6.2, C7.2, C8.2, C9.2, C10.2, C11.2, C12.1, C13.2, C14.1, C15.2, C16.2, C18.2, C19.2, C20.2, C21.2, C22.2, C23.2, C24.1, C25.1, C26.1, C27.2, C28.2, C29.2, C30.2, C31.2, C32.1, C33.2, C34.2, C35.2, C36.2, C37.2, C38.2, C39.2, C40.2, C41.2, C42.2, C43.2, C44.2, C45.2, C46.2, C47.2, C48.1, C49.2, D2.1 (A1), D3.1 (K), D4.2 (A), D14.1 (K), IR1.1 (Gnd), J2.1, J3.2, J4.1, J4.4, J5.2, J6.10, J7.1, J7.4, J8.1, J8.4, LCD1.1 (VSS), P1.5 (GND), P1.6 (shield), Q1.2 (E), Q4.2 (E), Q7.2 (E), Q9.2 (S), R13.2, R14.2, R15.2, R16.2, R18.2, R19.2, R24.1, R32.2, R46.2, RN1.1 (R1.1), RN1.2 (R2.1), RN1.3 (R3.1), RN1.4 (R4.1), RN2.1 (R1.1), RN2.2 (R2.1), RN2.3 (R3.1), RN2.4 (R4.1), RV1.1, SW1.1, SW2.1, SW3.1, SW4.1, SW5.1, U1.4 (GND), U2.4 (GND), U3.4 (DI), U3.5 (GND), U4.1 (GND), U5.2 (GND), U6.2 (GND), U7.12 (VSSA), U7.18 (VSS), U7.31 (VSS), U7.47 (VSS), U7.63 (VSS), U8.10 (GND), U8.19 (CE), U9.2, U9.3, U10.2, U10.3, U11.9 (GND), U12.2, U12.3, U13.2, U13.3, U14.2, U14.3, U15.2, U15.3, U16.1 (GND), Y2.3; also elsewhere on the board
unnamed: BT1.1 (+), C30.1, U7.1 (VBAT)
unnamed: C9.1, U2.3 (Tim_Cap)
unnamed: C37.1, IR1.2 (Vs), R43.2
unnamed: C47.1, Q8.1 (G), R61.1
unnamed: D1.2 (A), D2.2 (A2), F1.1
unnamed: D3.2 (A), R11.2
unnamed: D4.1 (K), L1.1, U2.2 (Sw_Emit)
unnamed: D5.2 (A), P1.1 (VCC)
unnamed: D6.2 (A), R33.2
unnamed: D7.1 (A), LS1.2, Q7.3 (C)
unnamed: D8.2 (A), R47.1
unnamed: D9.2 (A), R49.1
unnamed: D10.2 (A), R51.1
unnamed: D11.2 (A), R53.1
unnamed: D12.2 (A), R55.1
unnamed: D13.2 (A), R57.1
unnamed: D14.2 (A), R62.2
unnamed: IR1.3 (Out), R44.1, R45.1
unnamed: LCD1.3 (Vo), RV1.2
unnamed: LCD1.15 (PSB), R24.2
unnamed: LCD1.20 (BLK), R25.1
unnamed: P1.2 (D-), R20.2
unnamed: P1.3 (D+), R21.2, R22.2
unnamed: Q1.1 (B), R17.2
unnamed: Q1.3 (C), R3.2, U3.2 (~RE~), U3.3 (DE)
unnamed: Q4.1 (B), R31.2
unnamed: Q4.3 (C), R25.2
unnamed: Q7.1 (B), R38.2
unnamed: Q8.3 (D), R59.2
unnamed: Q9.3 (D), R60.2, R61.2
unnamed: R1.2, U2.1 (Sw_Coll), U2.7 (I_Sense), U2.8 (Drv_Coll)
unnamed: R2.2, R8.2, U3.1 (RO)
unnamed: R7.2, U1.2 (DO(IO1))
unnamed: R10.2, R16.1, U1.6 (CLK)
unnamed: R4.2, R14.1, U1.1 (~CS)
unnamed: R6.2, R15.1, U1.5 (DI(IO0))
unnamed: R9.2, R19.1, U2.5 (V_Sense)
unnamed: R23.2, U7.14 (WKUP/USART2_CTS/ADC12_IN0/TIM2_CH1_ETR/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)
unnamed: R47.2, U9.1
unnamed: R49.2, U10.1
unnamed: R51.2, U12.1
unnamed: R53.2, U13.1
unnamed: R55.2, U14.1
unnamed: R57.2, U15.1
VIN: F1.2, J2.2

Notes on the sheet:
Power Block
Output Block
LCD ST7920
Input Block
EFROM Data

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
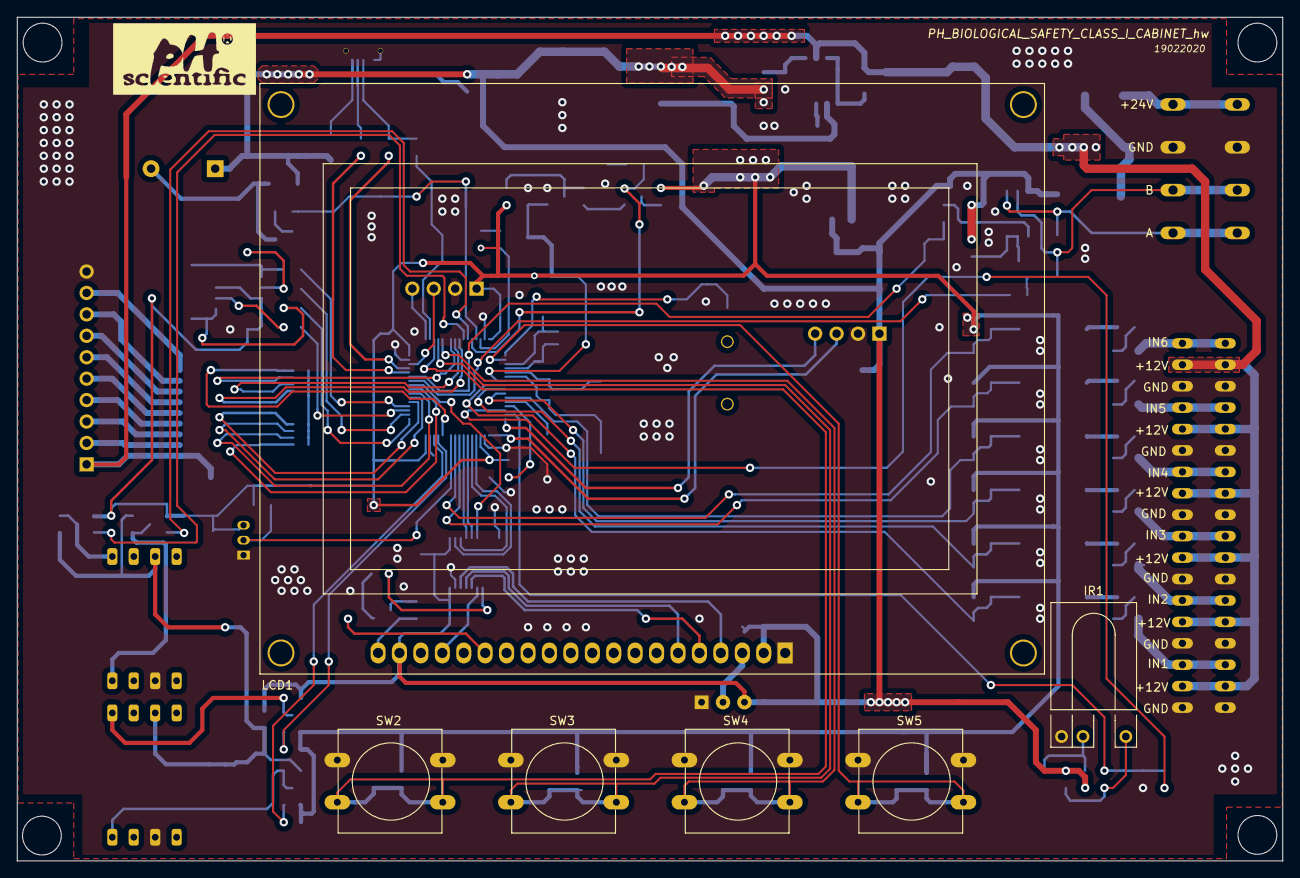
[picture p15: board ph_air_shower_controller_hw.kicad_pcb from above]

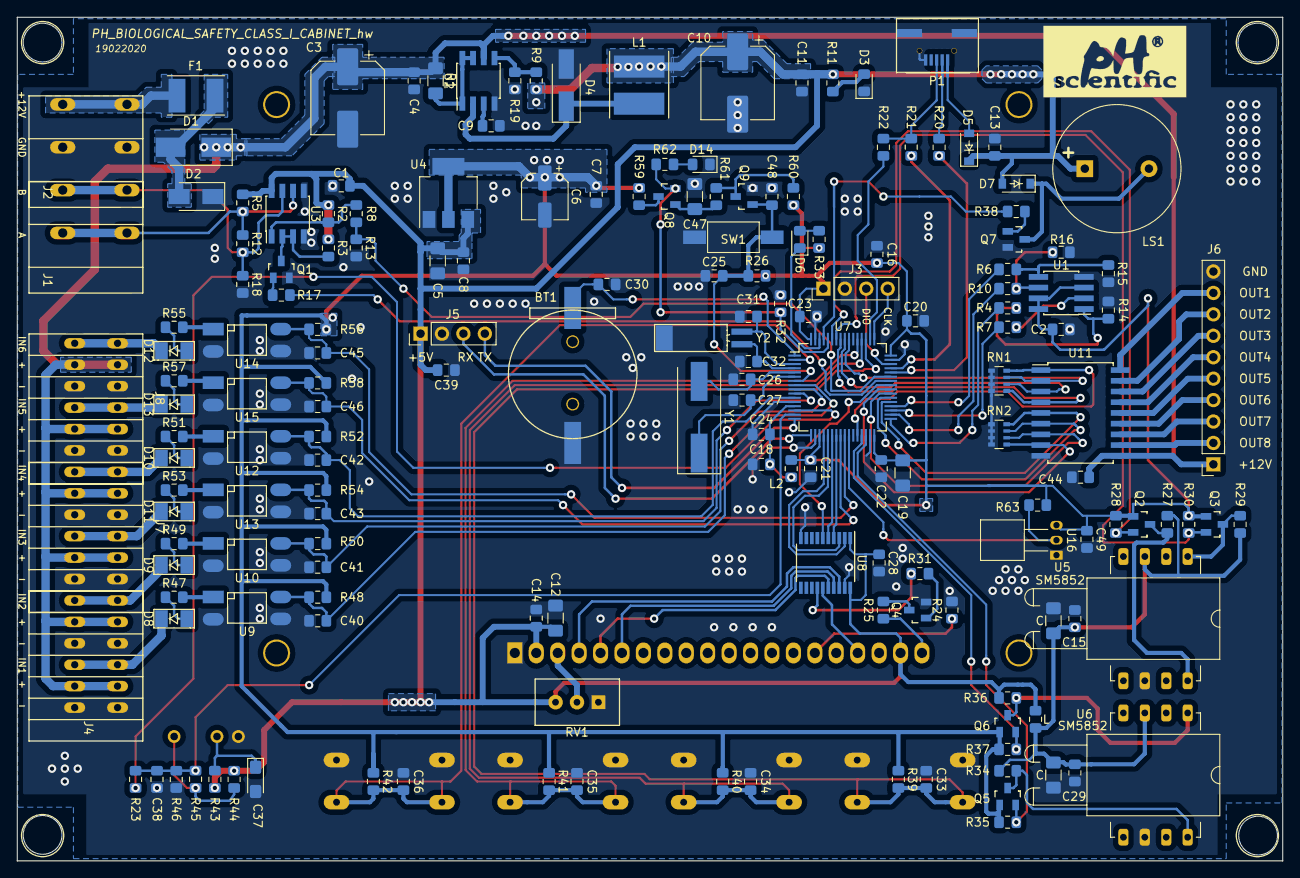
[picture p16: board ph_air_shower_controller_hw.kicad_pcb from below]

Board: 2 copper layers, 150.0 x 100.0 mm, 179 parts (173 on the bottom side), 125 nets.

Other parts of the board:
C: C_1206_3216Metric_Pad1.42x1.75mm_HandSolder
C#2: C_1206_3216Metric_Pad1.42x1.75mm_HandSolder
L: R_0805_2012Metric_Pad1.15x1.40mm_HandSolder

Their connections:
+5V: C.1, C#2.1, L.1, L.2; also elsewhere on the board
GND: C.2, C#2.2; also elsewhere on the board
