VinhThoHo/ph_air_shower_hw/(commit log)

2020-04-02 Update Board Relay
    [ph_air_shower_controller_hw.sch, ph_air_shower_relay_hw.kicad_pcb, ph_air_shower_relay_hw.sch, ph_frame_air_shower_controller_hw.dxf, ph_frame_air_shower_relay_hw.dxf]
2020-04-02 Updating PCB Controller
    [ph_air_shower_controller_hw.sch, ph_frame_air_shower_controller_hw.dxf]
2020-04-17 Update Diagram system
    [ph_air_shower_controller_hw.kicad_pcb, ph_air_shower_controller_hw.sch]
